mmajjedi/TVF-Player/(commit log)

2026-08-31 wiring diagram
2026-09-22 Add SD card module option with video menu
    Keep playing a single clip from the ESP32's flash (the default) and add
    VIDEO_SOURCE SOURCE_SDCARD to play from an SD card module on its own SPI
    bus (SCK 14, MOSI 13, MISO 19, CS 4).
    - Menu lists the .tvf files on the card; three buttons (UP 32, DOWN 33,
    OK 25) scroll, play, change volume and return to the menu. A card with
    one video plays straight away.
    - Each .tvf stores its DFPlayer audio folder (header byte 24, was padding)
    so a picked video plays with its own sound. Old files read 0 = /mp3.
    - Frame index is read in 256-entry blocks instead of loaded whole, so
    long clips fit in RAM.
    - tvfpack.py: --sdcard, --slot, --name. tvfinfo.py show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
2026-09-24 wiring diagram updated
